TesisProject/esp32cam/hardware/3d/case_camara_tapa.stl

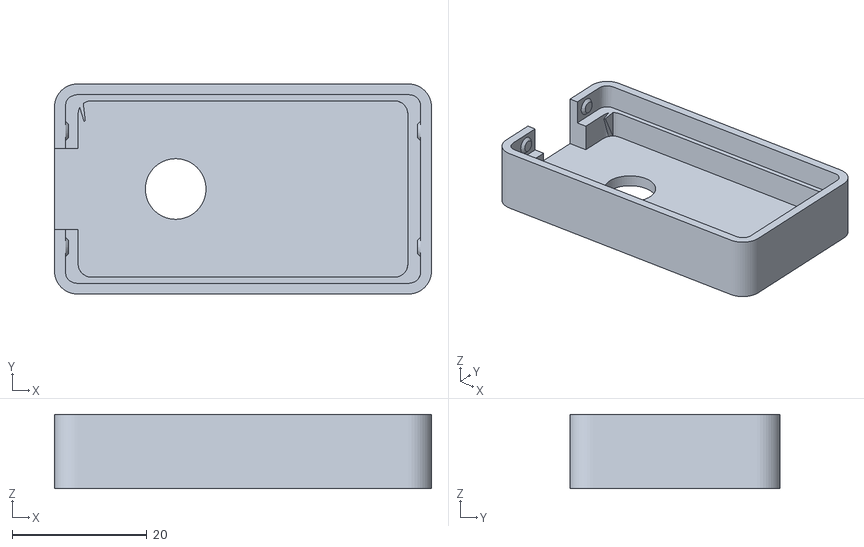
[picture p5: CAD file, 2026-11-11]
hardware/3d/case_camara_tapa.stl
56.0 x 31.2 x 11.0
