TesisProject/esp32cam/(commit log)

2026-09-16 Firmware ESP32-CAM autosuficiente: dashboard, camara y bateria
    Monitor web que corre entero en la ESP32-CAM AI-Thinker, sin Raspberry Pi
    ni servidor externo. Sketch de Arduino IDE sin librerias externas.
    - Dashboard empotrado en el firmware (dashboard_html.h): un solo flasheo,
    sin plugin de LittleFS. Lee /config al arrancar, asi que no duplica
    ninguna constante de config.h.
    - Modo de video hibrido: foto fija periodica + stream MJPEG bajo demanda.
    Multiplica por ~2,4 la autonomia frente a streaming continuo.
    - Medida de bateria con ADS1115 por I2C (driver propio sobre Wire) en
    GPIO14/15. La camara ocupa todo ADC1 util y ADC2 no sirve con WiFi,
    de ahi el ADC externo.
    - Curvas de des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
2026-09-17 Migrar firmware a cliente REST con deep sleep
    Reemplaza el dashboard/servidor HTTP local por un cliente que captura
    una foto, la sube por POST a la Raspberry Pi (fog node) y entra en
    deep sleep entre capturas para autonomia con pilas AA.
2026-09-17 update led
2026-10-12 feat: modulos en src/, telemetria, subida al endpoint de camara y preparacion OTA
    - Reorganiza el sketch: esp32cam.ino en la raiz y modulos en src/
    (camera, wifi, upload, ota). El .ino solo orquesta el ciclo.
    - Quita la medida de bateria (ADS1115) y su configuracion.
    - WIFI: lee la MAC del eFuse (WiFi.macAddress() devolvia ceros).
    - E1: la subida va a POST /api/v1/camera/frames (la camara se
    identifica por su credencial); antes apuntaba a un endpoint que el
    Fog solo tiene como GET de administracion.
    - E2: el body del POST se reserva en RAM interna si no hay PSRAM.
    - E3: envia 10 campos de telemetria en el mismo multipart.
    - E4: esquema Minimal SPIFFS (dos ranuras OTA), FW_VERSION y rol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
2026-10-12 feat: aprovisionamiento por USB y almacen de configuracion en NVS (E6)
    - src/settings: unica puerta a la NVS (Preferences) con el esquema
    completo (WiFi activa y pendiente, Fog, credencial, captura, revision,
    version OTA rechazada). Cada grupo va en un blob atomico y un cambio de
    SETTINGS_SCHEMA_VERSION borra el namespace. Un ciclo normal solo lee.
    - src/provision: con la NVS sin WiFi, la placa espera por serie una linea
    JSON {wifi, fogHost, fogPort} durante PROV_WAIT_MS; si no llega, duerme
    PROV_RETRY_SLEEP_MS. La valida entera con cJSON (del core) antes de
    escribir y responde PROV: OK / PROV: ERROR. Ventana de
    re-aprovisionamiento (o {"cmd":"erase"}) solo tras encendido o RST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
2026-10-13 feat: bateria Li-ion 1S por GPIO13 (ADC2), calibracion en NVS y herramienta de monitor
    Claude-Session: https://claude.ai/code/session_012bUfCT19oDv8bbjq3KN1Qw
2026-10-13 feat: LED de estado y diagnostico de brownout en el monitor de bateria
    El LED rojo (GPIO33) indica si esta midiendo, si la red esta levantada y si
    hay un dispositivo conectado; 3 destellos largos al arrancar avisan de que
    el arranque anterior acabo en brownout. Potencia de TX a 8,5 dBm para bajar
    el pico de corriente con la celda + MT3608. Probado en la placa a bateria.
2026-10-17 feat: WiFi y host del Fog solo por USB, protegidos ante cambios de esquema y OTA
    Revision 3 del plan (2026-10-17): la WiFi nunca llega por red.
    - Se retira la WiFi pendiente de E8 (wifi_pend, wifi_tries, wifi_rej).
    - Un cambio de SETTINGS_SCHEMA_VERSION ya no hace clear(): borra todo
    salvo wifi, fog y bat_cal (reset_keeping_usb_keys), con structs
    congelados por static_assert.
    - CLAUDE.md: reglas de "OTA y configuracion por USB".
    - El aprovisionamiento acepta fin de linea CR, LF o CRLF (monitor del IDE).
    - CAPTURE_INTERVAL_MS vuelve a 5 min; README con la estimacion de consumo
    con celda Li-ion (sin medir todavia).
    - tools/wifi_rssi: sketch aparte para medir el RSSI con la WiFi de la NV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
2026-10-18 feat: credencial de la camara en la NVS por USB, un unico .bin sin secrets.h
    El id de camara, X-API-Key y X-API-Token se graban con la linea de
    aprovisionamiento ("camera":{"id","apiKey","apiToken"}), por el script o
    pegada en el monitor serie. Sustituye al alta por MAC (E7).
    - settings: blob "cred" congelado (144 B) y protegido en kUsbKeys ante
    cambios de esquema; aprovisionada = wifi Y cred.
    - provision: valida camera (id, key/token ASCII sin espacios) y escribe
    la WiFi la ultima; nunca imprime key ni token.
    - upload: la credencial llega como parametro desde la NVS.
    - config.h: fuera secrets.h y su #error; FW_VERSION 2.
    - Borrado secrets.h.example; script, plantilla, README y CLAUDE.m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
2026-10-18 feat: herramienta de banco ota_test para probar OTA y rollback
    Sketch aparte que recibe un .bin por HTTP (POST /update, sin auth: solo
    banco) y muestra las ranuras y su estado de rollback. Comprueba en la
    placa real que el .bin cabe en Minimal SPIFFS, que la NVS sobrevive y
    que una imagen sin confirmar vuelve sola a la anterior.
2026-10-18 feat: cliente OTA (E5), fotos atrasadas en LittleFS y hora del Fog
    FW_VERSION 3.
    - OTA: lee el bloque firmware de GET /api/v1/camera/config (wifi se
    ignora) en el primer ciclo bueno tras arranque en frio y cada 12.
    Instala solo si version > FW_VERSION y != ota_rej; verifica la firma
    ECDSA P-256 de la nube (clave publica de produccion compilada) antes de
    descargar; descarga en streaming y exige tamano y SHA-256 firmados.
    Detecta un rollback previo y apunta la version en ota_rej. Reintento
    con espera 1/2/4/8 ciclos si falla la descarga. Autotest con el vector
    de la nube en cada encendido.
    - Fotos atrasadas: si la subida falla (sin WiFi, error de red, 5xx) la
    foto se guarda en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
2026-10-19 docs: R8 (47K de IO13 a 3V3) depende del lote, comprobarla antes de montar el divisor
    La CAM-002 la traia y la CAM-001 no: con R8 la lectura de bateria no se
    puede calibrar. Se corrige la afirmacion anterior de que en GPIO13 solo
    esta el divisor y se documenta la prueba con el ohmetro.
2026-10-19 feat: herramienta live_monitor con video en vivo, bateria y RSSI
    Sketch de banco/campo que junta battery_monitor y wifi_rssi y anade la
    camara en tiempo real (MJPEG en el puerto 81, UI y datos en el 80), para
    orientar cada camara sobre sus plazas viendo a la vez la senal y la
    bateria. Arranca en SVGA/12 como la foto de campo.
    GPIO13 es ADC2: cada intervalo (60 s, ajustable o desactivable desde la
    web) corta el video, apaga camara y WiFi, mide y lo vuelve a levantar.
    Lee de la NVS la WiFi, la calibracion y el id de la camara, sin escribirla.
2026-10-21 feat: flash (GPIO4) en LOW retenido en deep sleep y camara apagada durante el POST (FW_VERSION 4)
    R11 (47K a 3V3) dejaba el transistor del flash conduciendo a medias con el
    pin como entrada: el LED podia brillar flojo durante todo el deep sleep.
    Ahora go_to_sleep() lo fuerza a LOW con rtc_gpio_hold_en(), igual que PWDN.
    El sensor se apaga en cuanto la foto esta en PSRAM, antes del POST.
    Compilado sin avisos; sin probar en hardware.
    Claude-Session: https://claude.ai/code/session_01BdMC7QoZeyUHJCojtuFxNH
2026-10-31 feat: captura cada 30 s y chequeo OTA derivado del intervalo (FW_VERSION 5)
    CAPTURE_INTERVAL_MS pasa de 5 min a 30 s. OTA_CHECK_EVERY_CYCLES se
    calcula a partir del intervalo para seguir pidiendo la config al Fog una
    vez por hora (120 ciclos a 30 s); fijo en 12 seria cada 6 min.
2026-11-04 docs: 30 s de captura como decisión de diseño (HU-08)
2026-11-04 feat: camara desactivada en la nube deja de capturar y config separada de la OTA (HU-23)
    - "enabled" de GET /camera/config en una clave NVS nueva (cam_off). Desactivada: tras la bateria,
    sin sensor, solo WiFi + config y deep sleep de DISABLED_SLEEP_MS (2 min); reactivada vuelve a
    capturar en el ciclo siguiente.
    - Un 403 al subir fuerza a releer la config en el mismo ciclo.
    - La config se lee cada CONFIG_CHECK_EVERY_CYCLES (10 = 5 min); la oferta OTA sigue una vez por hora.
    - CLAUDE.md: OTA_CHECK_EVERY_CYCLES son 120 ciclos a 30 s, no 12. FW_VERSION 6.
2026-11-10 feat: add charging mode (telemetry-only cycle without camera)
    When the Fog config says charging: true the camera stays enabled but never
    turns on the sensor or the flash: every CHARGING_SLEEP_MS (5 min) it connects
    and posts only its telemetry to /api/v1/camera/telemetry. The 202 response
    carries enabled/charging, so leaving the mode needs no separate config read.
    - Enter through the config: a 403 on upload or the periodic config read.
    - NVS key cam_chg (written only when it changes); disabled takes precedence.
    - Any non-2xx answer while charging re-reads the config, so an old Fog
    cannot leave the camera stuck in charging mode.
    - A 2xx telemetry report also confirms a pending OTA image.
    -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
2026-11-10 ci: build firmware on every push and publish releases on fw-v* tags
    GitHub Actions compiles the sketch with arduino-cli, the esp32 core 3.3.12 and
    the Minimal SPIFFS FQBN, and uploads the app, merged image, ELF and SHA256SUMS
    as a workflow artifact. Pushing a fw-v<FW_VERSION> tag also checks the tag
    against config.h and creates a GitHub Release with those files.
    Claude-Session: https://claude.ai/code/session_01Ti5m1rj79t91KKkSCo8PXZ
2026-11-11 docs(hardware): add power topology, wiring guide and 3D enclosure models
    Document the solar power chain (panel, TP4056 with protection, 18650
    cells in parallel, MT3608/SX1308 boost at 5.0 V), the wiring inside the
    compact enclosure, the GPIO13 divider assembly and why the firmware
    cutoff stays at 3.3 V. Add the printable STLs and the OpenSCAD source
    for the power box, plus the camera case and wall mount.
    Claude-Session: https://claude.ai/code/session_01CWRf5HskPTWyzpsc4YErtu
